SebastianOberschwendtner/OTP24_oTrainControl/schematic/rail_transceiver/rail_transceiver.kicad_pcb

## KiCad design schematic/rail_transceiver/rail_transceiver.kicad_pcb (2024-01-21)

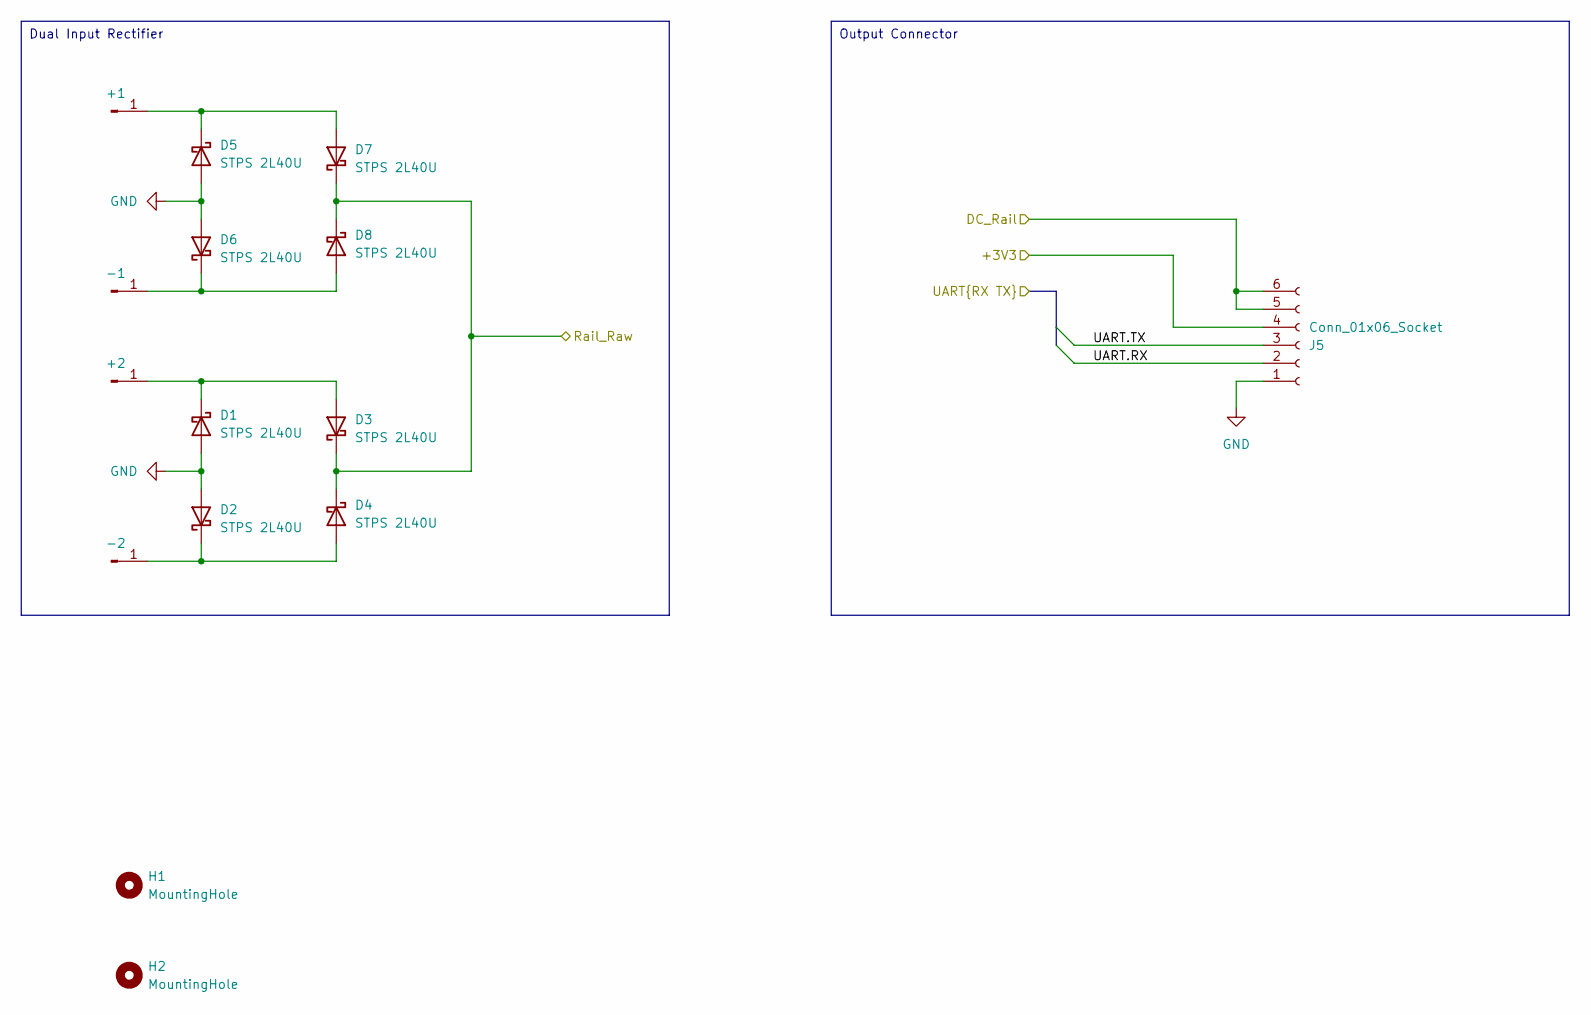
[picture p1: schematic io.kicad_sch, Input and Output Connectors]

Parts:
+1, +2: Conn_01x01_Pin; SolderWirePad_1x01_SMD_1x2mm
-1, -2: Conn_01x01_Pin; SolderWirePad_1x01_SMD_1x2mm
D1, D2, D3, D4, D5, D6, D7, D8: STPS 2L40U; D_SMB
H1, H2: MountingHole; MountingHole_2.2mm_M2
J5: Conn_01x06_Socket; Molex_SPOX_5268-06A_1x06_P2.50mm_Horizontal

Connections:
+3V3: J5.4; also elsewhere on the board
/Connectors/DC_Rail: J5.5, J5.6; also elsewhere on the board
/Connectors/Rail_Raw: D3.1 (K), D4.1 (K), D7.1 (K), D8.1 (K); also elsewhere on the board
/Connectors/UART.RX: J5.2; also elsewhere on the board
/Connectors/UART.TX: J5.3; also elsewhere on the board
GND: D1.2 (A), D2.2 (A), D5.2 (A), D6.2 (A), J5.1; also elsewhere on the board
unnamed: +1.1, D5.1 (K), D7.2 (A)
unnamed: +2.1, D1.1 (K), D3.2 (A)
unnamed: -1.1, D6.1 (K), D8.2 (A)
unnamed: -2.1, D2.1 (K), D4.2 (A)

Notes on the sheet:
Output Connector
Dual Input Rectifier

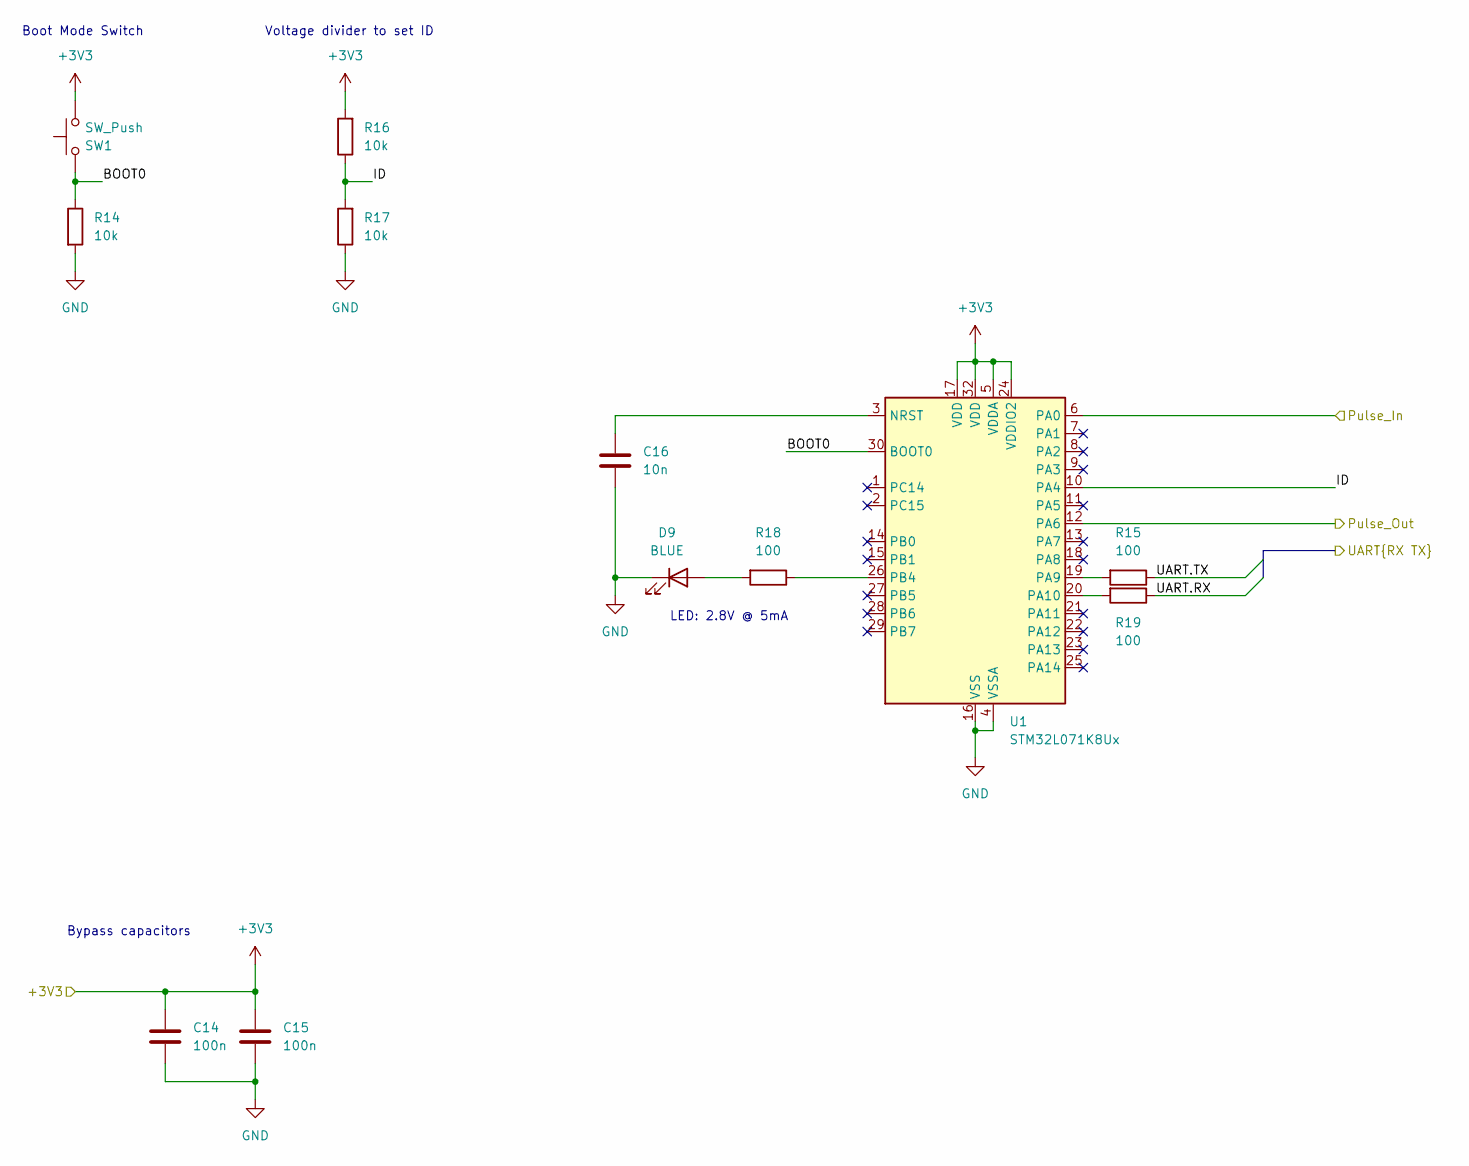
[picture p2: schematic processor.kicad_sch]

Parts:
C14, C15: 100n; C_0805_2012Metric_Pad1.18x1.45mm_HandSolder
C16: 10n; C_0805_2012Metric_Pad1.18x1.45mm_HandSolder
D9: BLUE; LED_0603_1608Metric_Pad1.05x0.95mm_HandSolder
R14, R16, R17: 10k; R_0805_2012Metric_Pad1.20x1.40mm_HandSolder
R15, R18, R19: 100; R_0805_2012Metric_Pad1.20x1.40mm_HandSolder
SW1: SW_Push; SW_SPST_Wuerth_WS-TASU_SMT
U1: STM32L071K8Ux; QFN-32-1EP_5x5mm_P0.5mm_EP3.45x3.45mm

Connections:
+3V3: C14.1, C15.1, R16.2, SW1.1, U1.5 (VDDA), U1.17 (VDD), U1.24 (VDDIO2), U1.32 (VDD); also elsewhere on the board
/Connectors/UART.RX: R19.1; also elsewhere on the board
/Connectors/UART.TX: R15.1; also elsewhere on the board
/Front End/Pulse_In: U1.6 (PA0); also elsewhere on the board
/Front End/Pulse_Out: U1.12 (PA6); also elsewhere on the board
/Processor/BOOT0: R14.1, SW1.2, U1.30 (BOOT0)
/Processor/ID: R16.1, R17.2, U1.10 (PA4)
GND: C14.2, C15.2, C16.2, D9.1 (K), R14.2, R17.1, U1.4 (VSSA), U1.16 (VSS), U1.31 (VSS), U1.33 (VSS); also elsewhere on the board
unnamed: D9.2 (A), R18.2
unnamed: C16.1, U1.3 (NRST)
unnamed: R15.2, U1.19 (PA9)
unnamed: R19.2, U1.20 (PA10)
unnamed: R18.1, U1.26 (PB4)

Notes on the sheet:
Bypass capacitors
Voltage divider to set ID
Boot Mode Switch
LED: 2.8V @ 5mA

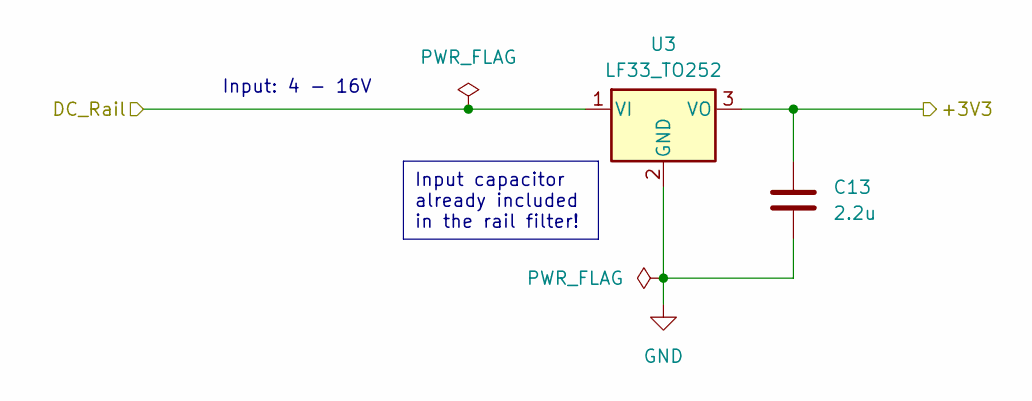
[picture p3: schematic power.kicad_sch, Power Supplies]

Parts:
C13: 2.2u; C_0805_2012Metric_Pad1.18x1.45mm_HandSolder
U3: LF33_TO252; TO-252-2

Connections:
+3V3: C13.1, U3.3 (VO); also elsewhere on the board
/Connectors/DC_Rail: U3.1 (VI); also elsewhere on the board
GND: C13.2, U3.2 (GND); also elsewhere on the board

Notes on the sheet:
Input capacitor already included in the rail filter!
Input: 4 - 16V

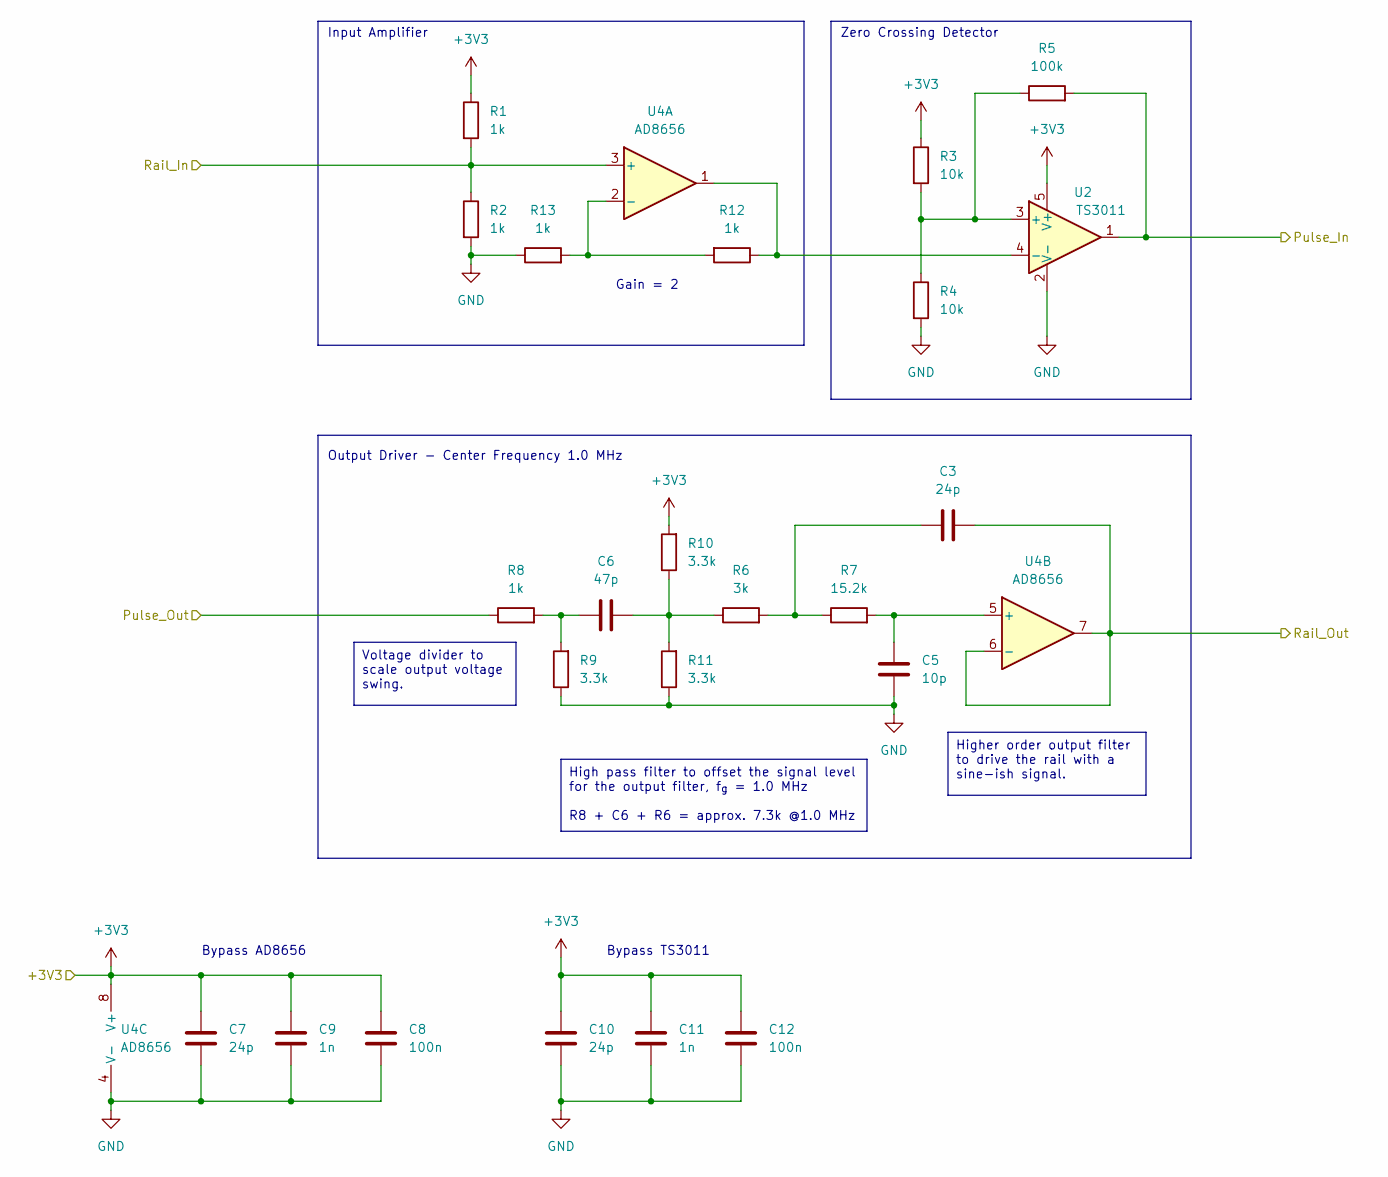
[picture p4: schematic front_end.kicad_sch, Front End]

Parts:
C3, C7, C10: 24p; C_0805_2012Metric_Pad1.18x1.45mm_HandSolder
C5: 10p; C_0805_2012Metric_Pad1.18x1.45mm_HandSolder
C6: 47p; C_0805_2012Metric_Pad1.18x1.45mm_HandSolder
C8, C12: 100n; C_0805_2012Metric_Pad1.18x1.45mm_HandSolder
C9, C11: 1n; C_0805_2012Metric_Pad1.18x1.45mm_HandSolder
R1, R2, R8, R12, R13: 1k; R_0805_2012Metric_Pad1.20x1.40mm_HandSolder
R3, R4: 10k; R_0805_2012Metric_Pad1.20x1.40mm_HandSolder
R5: 100k; R_0805_2012Metric_Pad1.20x1.40mm_HandSolder
R6: 3k; R_0805_2012Metric_Pad1.20x1.40mm_HandSolder
R7: 15.2k; R_0805_2012Metric_Pad1.20x1.40mm_HandSolder
R9, R10, R11: 3.3k; R_0805_2012Metric_Pad1.20x1.40mm_HandSolder
U2: TS3011; SOT-23-5_HandSoldering
U4: AD8656; MSOP-8_3x3mm_P0.65mm

Connections:
+3V3: C7.2, C8.2, C9.2, C10.2, C11.2, C12.2, R1.1, R3.1, R10.2, U2.5 (V+), U4.8 (V+); also elsewhere on the board
/Front End/Pulse_In: R5.2, U2.1; also elsewhere on the board
/Front End/Pulse_Out: R8.1; also elsewhere on the board
/Front End/Rail_In: R1.2, R2.1, U4.3 (+); also elsewhere on the board
/Front End/Rail_Out: C3.2, U4.6 (-), U4.7; also elsewhere on the board
GND: C5.1, C7.1, C8.1, C9.1, C10.1, C11.1, C12.1, R2.2, R4.2, R9.1, R11.1, R13.1, U2.2 (V-), U4.4 (V-); also elsewhere on the board
unnamed: C3.1, R6.2, R7.1
unnamed: C6.1, R6.1, R10.1, R11.2
unnamed: C6.2, R8.2, R9.2
unnamed: R3.2, R4.1, R5.1, U2.3 (+)
unnamed: R12.1, U2.4 (-), U4.1
unnamed: R12.2, R13.2, U4.2 (-)
unnamed: C5.2, R7.2, U4.5 (+)

Notes on the sheet:
High pass filter to offset the signal level for the output filter, f_{g} = 1.0 MHz R8 + C6 + R6 = approx. 7.3k @1.0 MHz
Voltage divider to scale output voltage swing.
Higher order output filter to drive the rail with a sine-ish signal.
Gain = 2
Output Driver - Center Frequency 1.0 MHz
Bypass AD8656
Bypass TS3011
Input Amplifier
Zero Crossing Detector

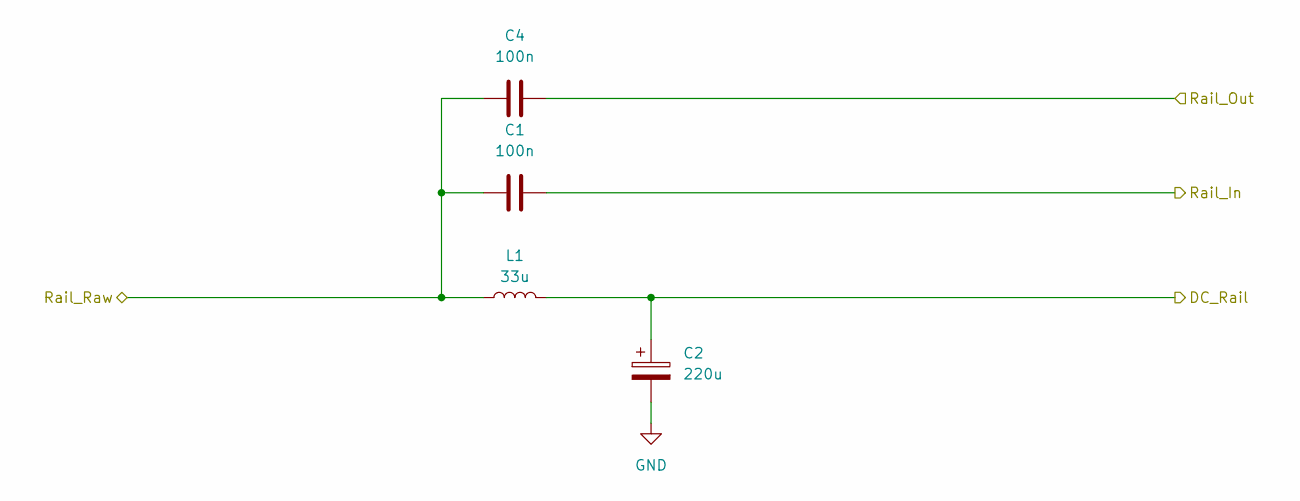
[picture p5: schematic rail_filter.kicad_sch, Rail Interface Filter]

Parts:
C1, C4: 100n; C_0805_2012Metric_Pad1.18x1.45mm_HandSolder
C2: 220u; CP_Elec_6.3x7.7
L1: 33u; L_Bourns_SRN5040

Connections:
/Connectors/DC_Rail: C2.1, L1.2; also elsewhere on the board
/Connectors/Rail_Raw: C1.2, C4.2, L1.1; also elsewhere on the board
/Front End/Rail_In: C1.1; also elsewhere on the board
/Front End/Rail_Out: C4.1; also elsewhere on the board
GND: C2.2; also elsewhere on the board

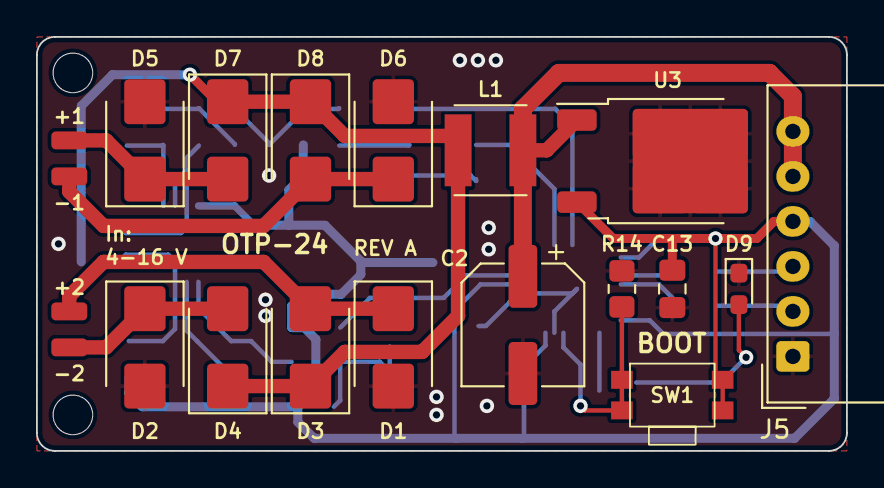
[picture p6: board rail_transceiver.kicad_pcb from above]

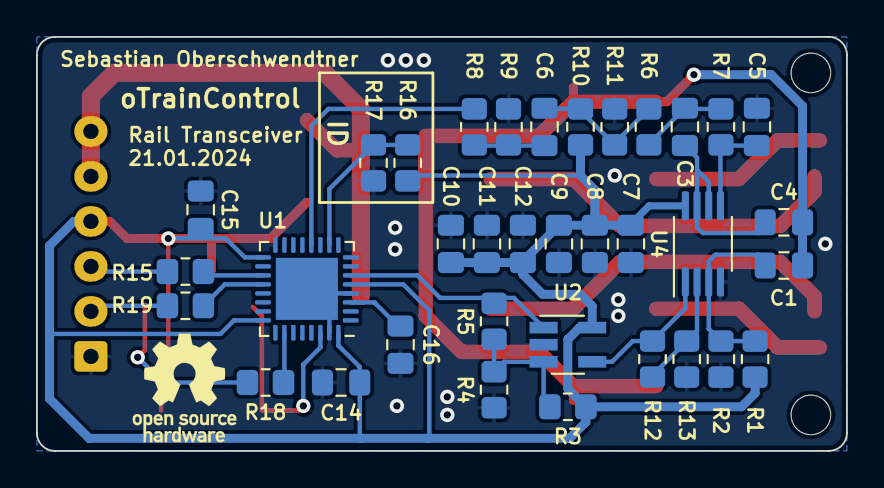
[picture p7: board rail_transceiver.kicad_pcb from below]

Board: 2 copper layers, 45.0 x 23.0 mm, 57 parts (35 on the bottom side), 28 nets.
