SebastianOberschwendtner/OTP24_oTrainControl/CHANGELOG.md

# Changelog for OTP24 - oTrainControl
## [v1.0.0](https://github.com/SebastianOberschwendtner/OTP24_oTrainControl/releases/tag/v1.0.0) *(dd-mm-yyyy)*
> Released by: `SO`

### Release Notes
- :tada: Initial release! :tada:

### Fixed Issues
- n/a
