SebastianOberschwendtner/OTP24_oTrainControl/(commit log)

2023-12-23 :tada: Simulation can design and analyze the loop.
    [vco.csv]
2024-01-04 Removes simulation as it is no longer part of the project.
    [vco.csv]
2024-01-21 :nut_and_bolt: Initial PCB of rail transceiver.
    [front_end.kicad_sch, io.kicad_sch, power.kicad_sch, processor.kicad_sch, rail_filter.kicad_sch, rail_transceiver.kicad_pcb, rail_transceiver.kicad_sch]
2024-04-25 🛠️ Adds reference to OTOS submodule.
